steeb-k/fightstick-customized/Arcade-stick_bottom_board_v1_layout.png

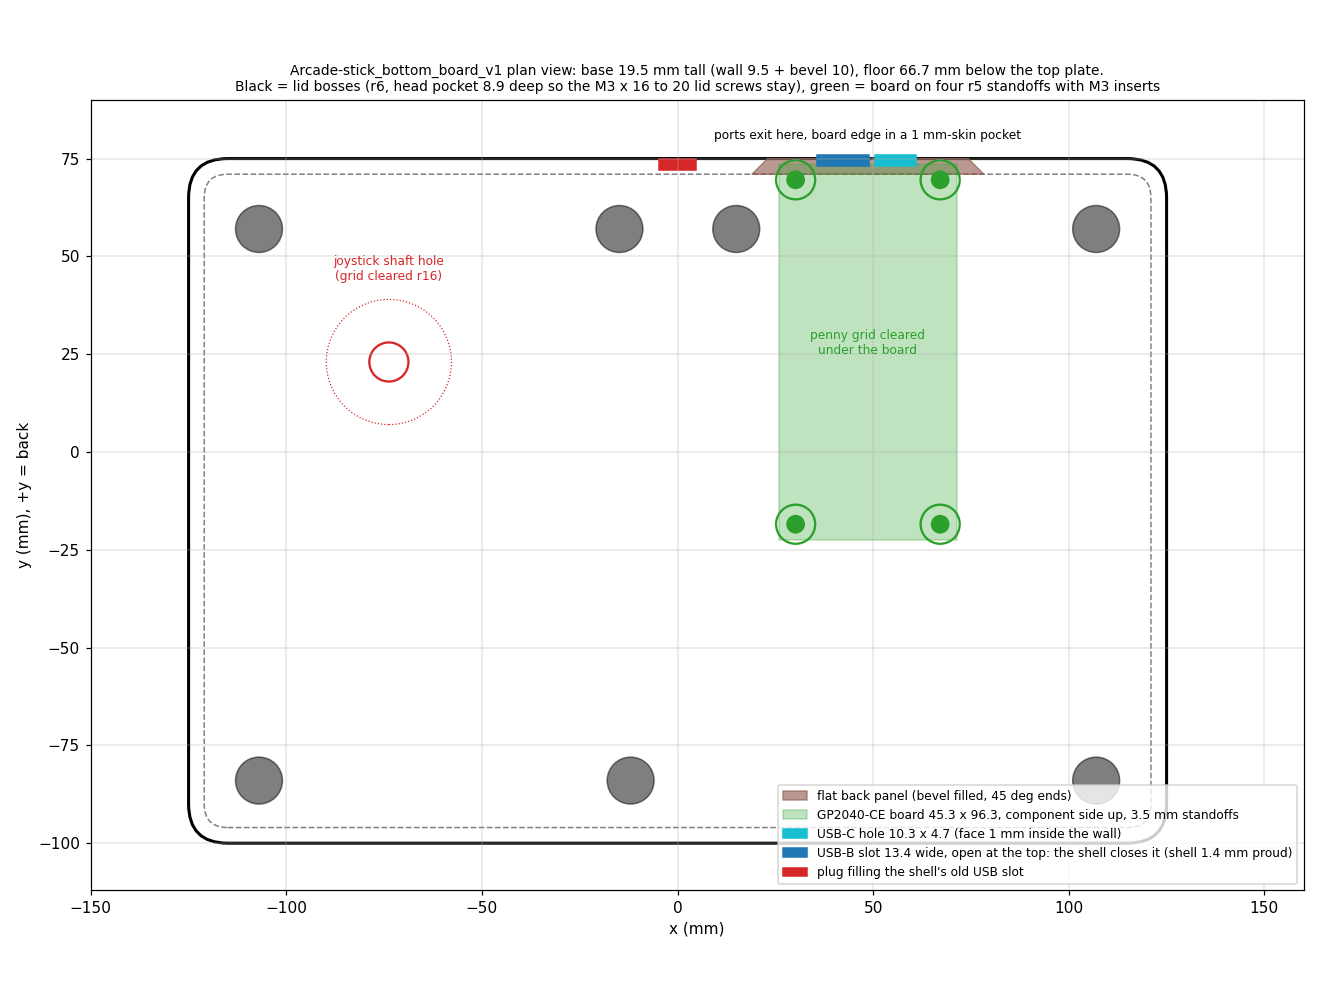
Arcade-stick_bottom_board_v1_layout.png
