steeb-k/fightstick-customized/Arcade-stick_top_v7_layout_layers.png

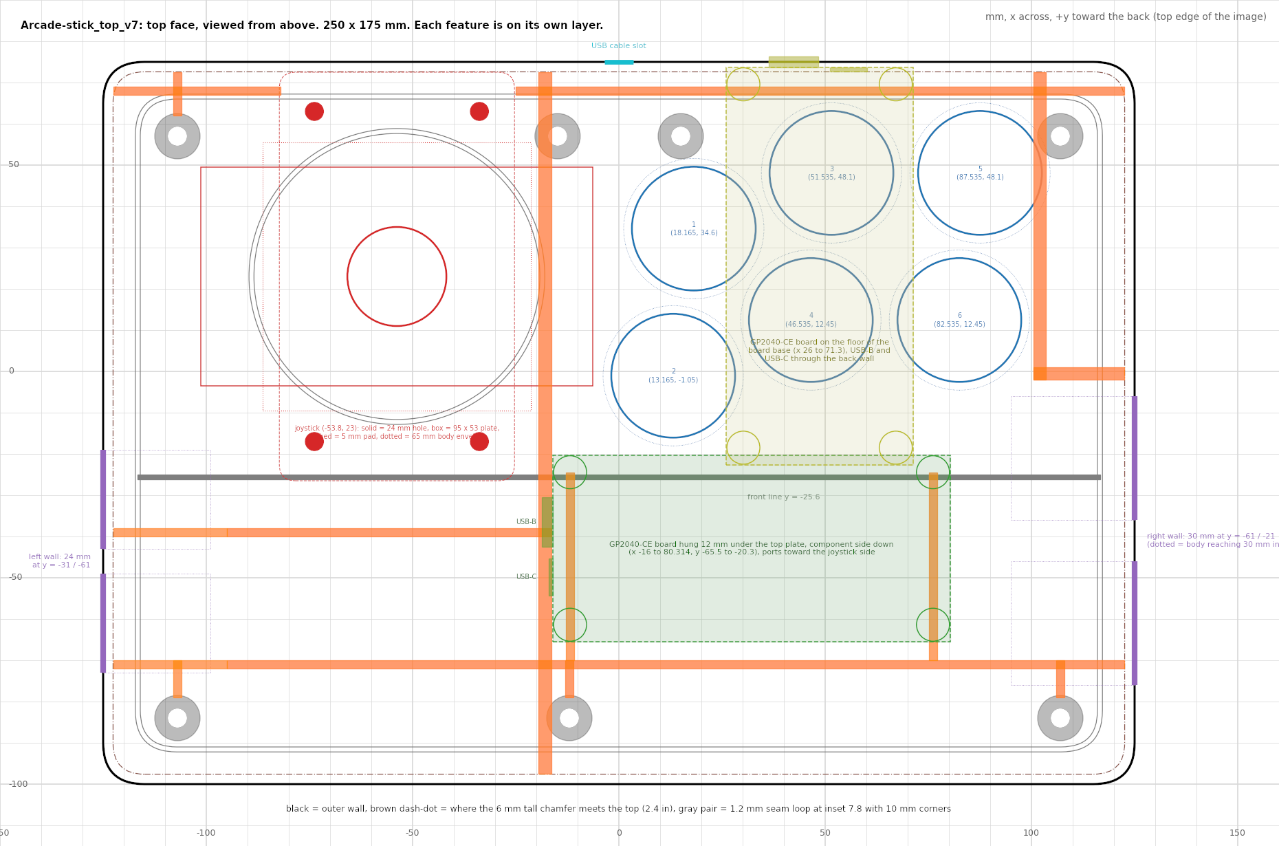
Arcade-stick_top_v7_layout_layers.png
