steeb-k/fightstick-customized/render_bottom_board_v1.png

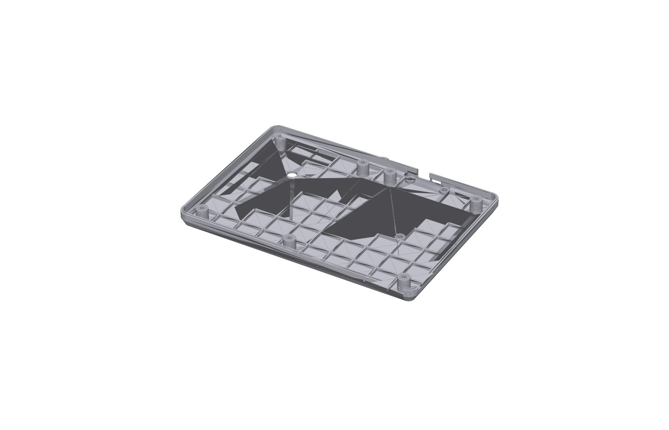
render_bottom_board_v1.png
