steeb-k/fightstick-customized/render_bottom_board_v1_back.png

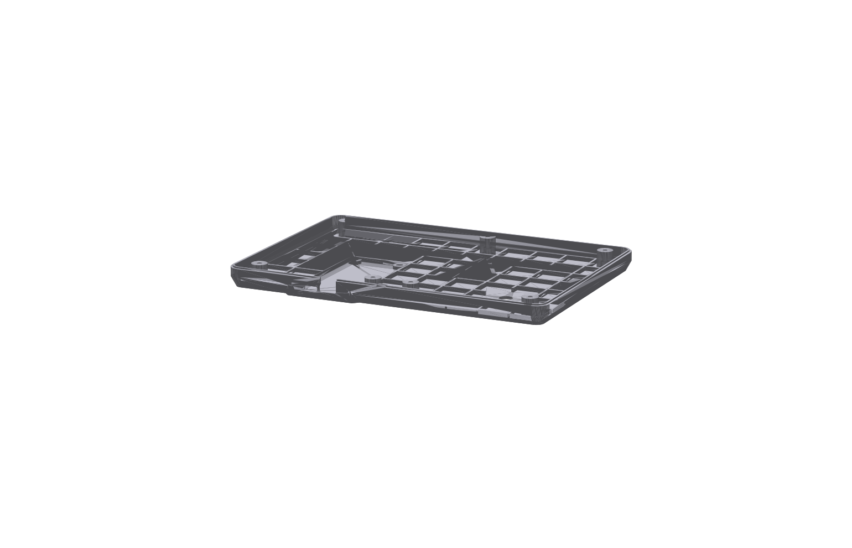
render_bottom_board_v1_back.png
