steeb-k/fightstick-customized/render_top_v7.png

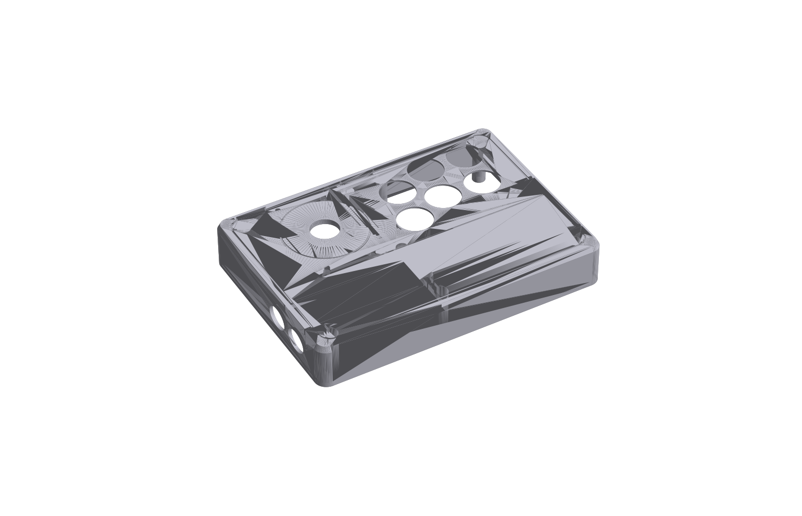
render_top_v7.png
