steeb-k/fightstick-customized/samples/plan_8btn.png

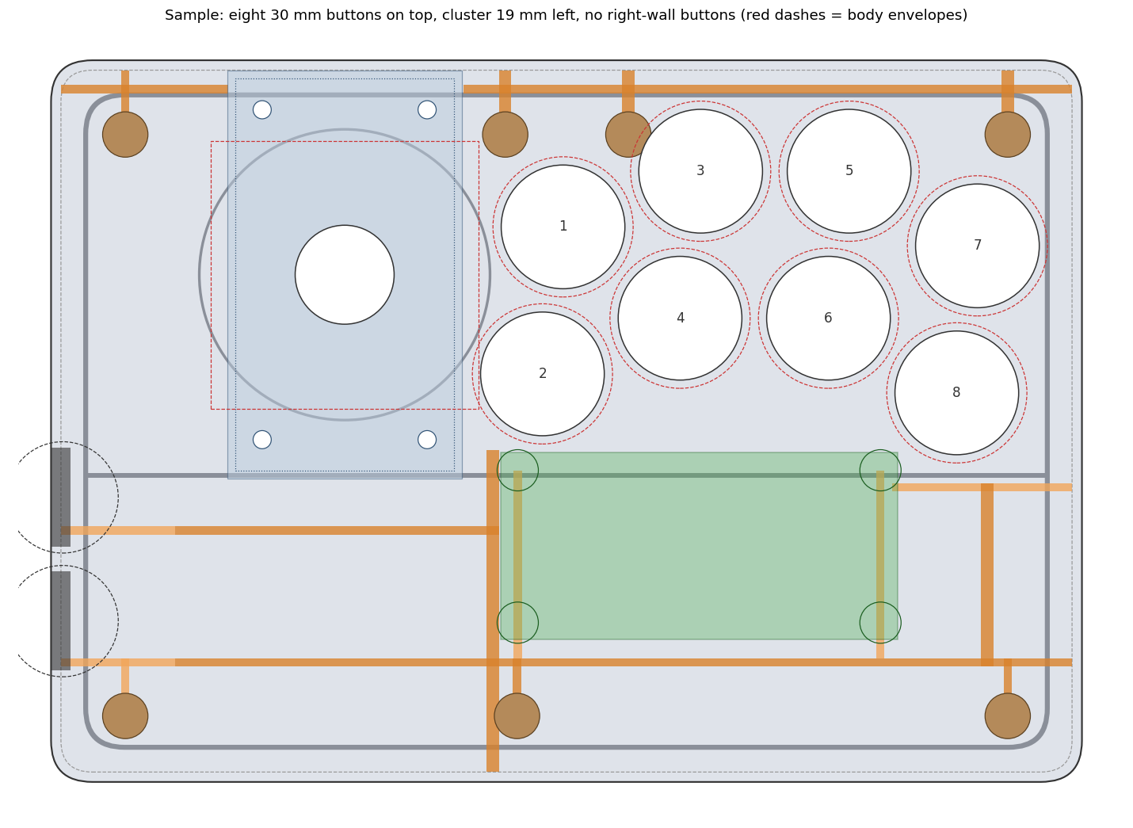
samples/plan_8btn.png
