steeb-k/fightstick-customized/samples/plan_diamond.png

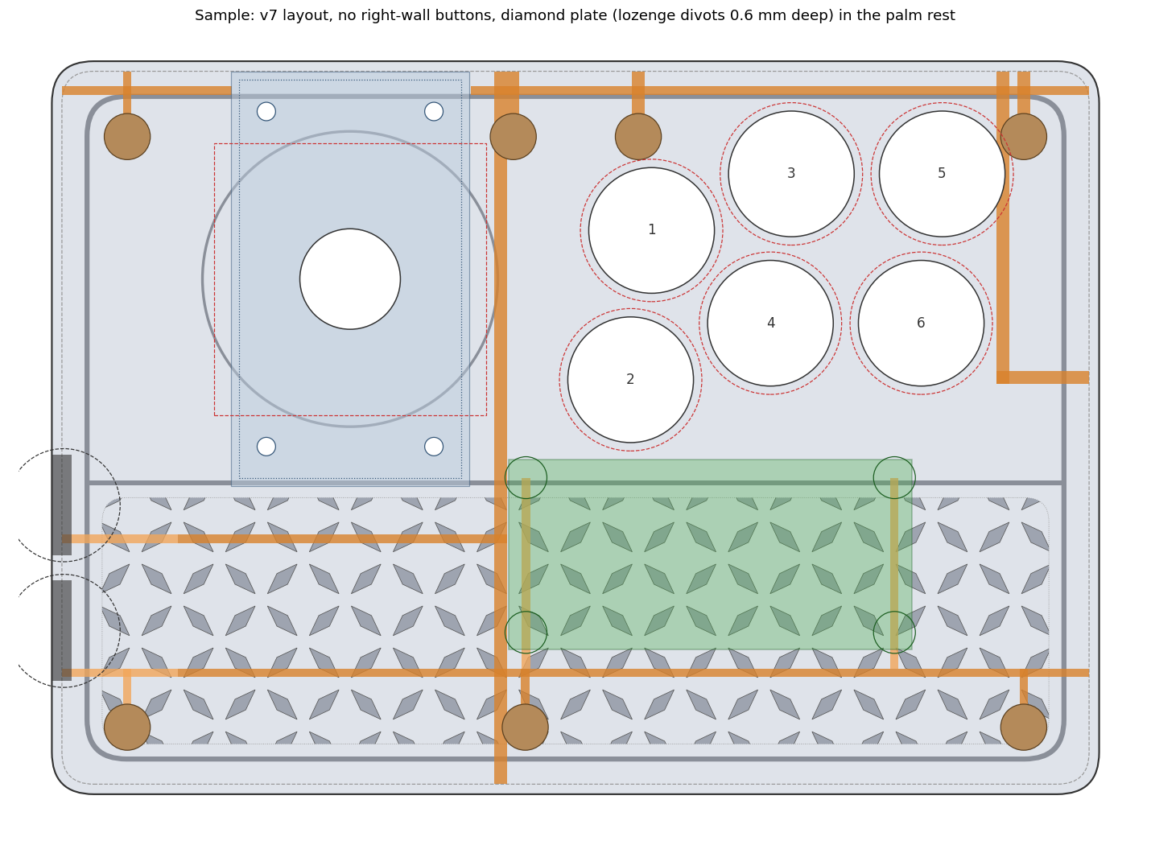
samples/plan_diamond.png
