steeb-k/fightstick-customized/samples/section_diamond_x0.png

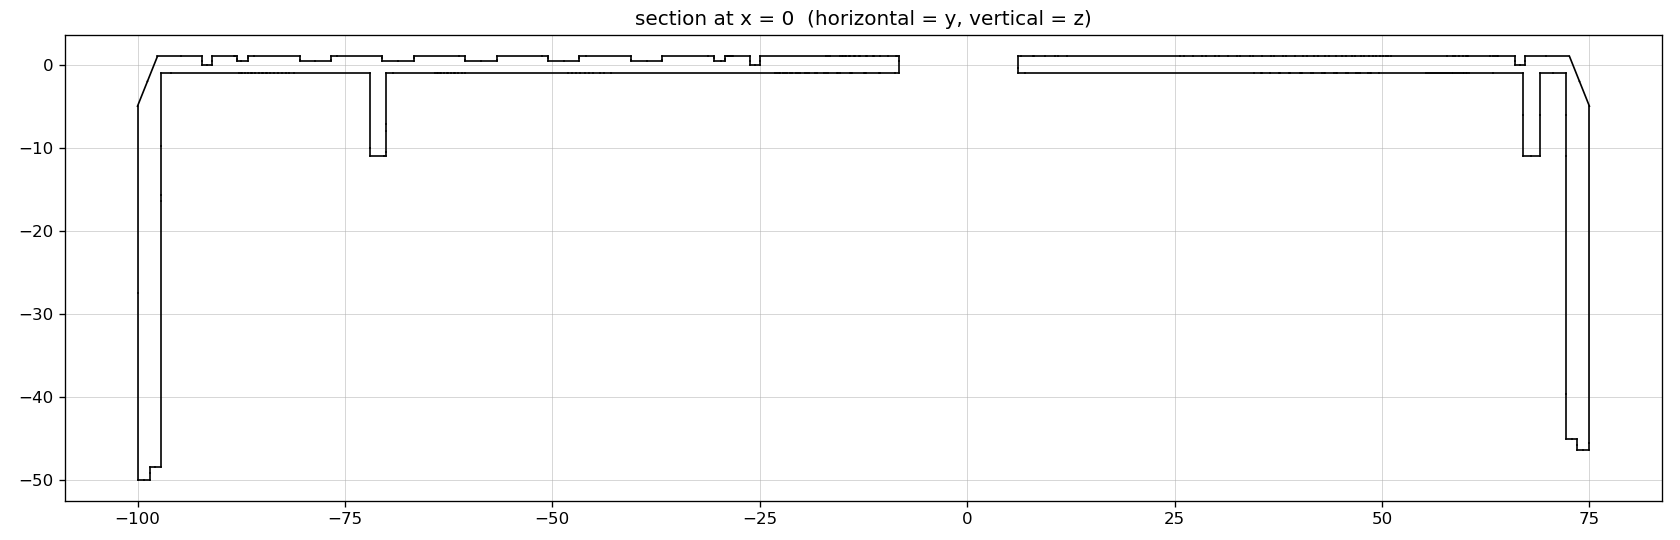
samples/section_diamond_x0.png
