steeb-k/fightstick-customized/section_board_v1_back.png

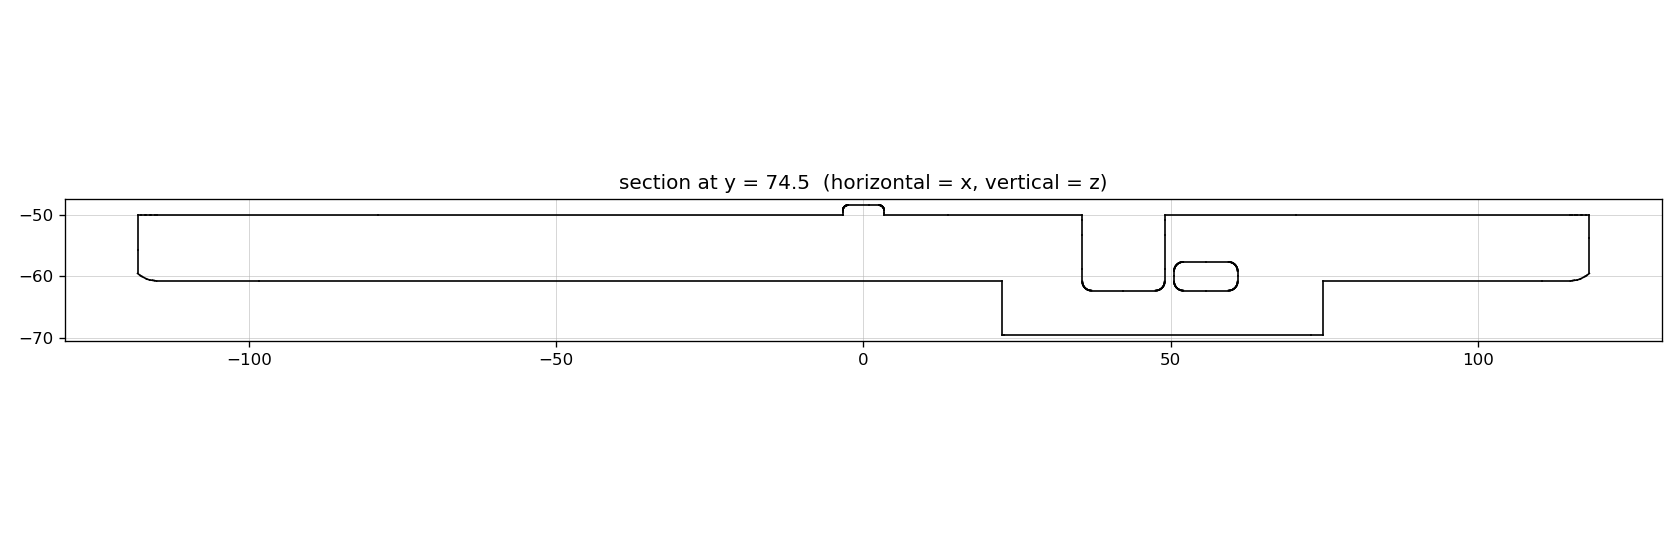
section_board_v1_back.png
