steeb-k/fightstick-customized/section_board_v1_ports.png

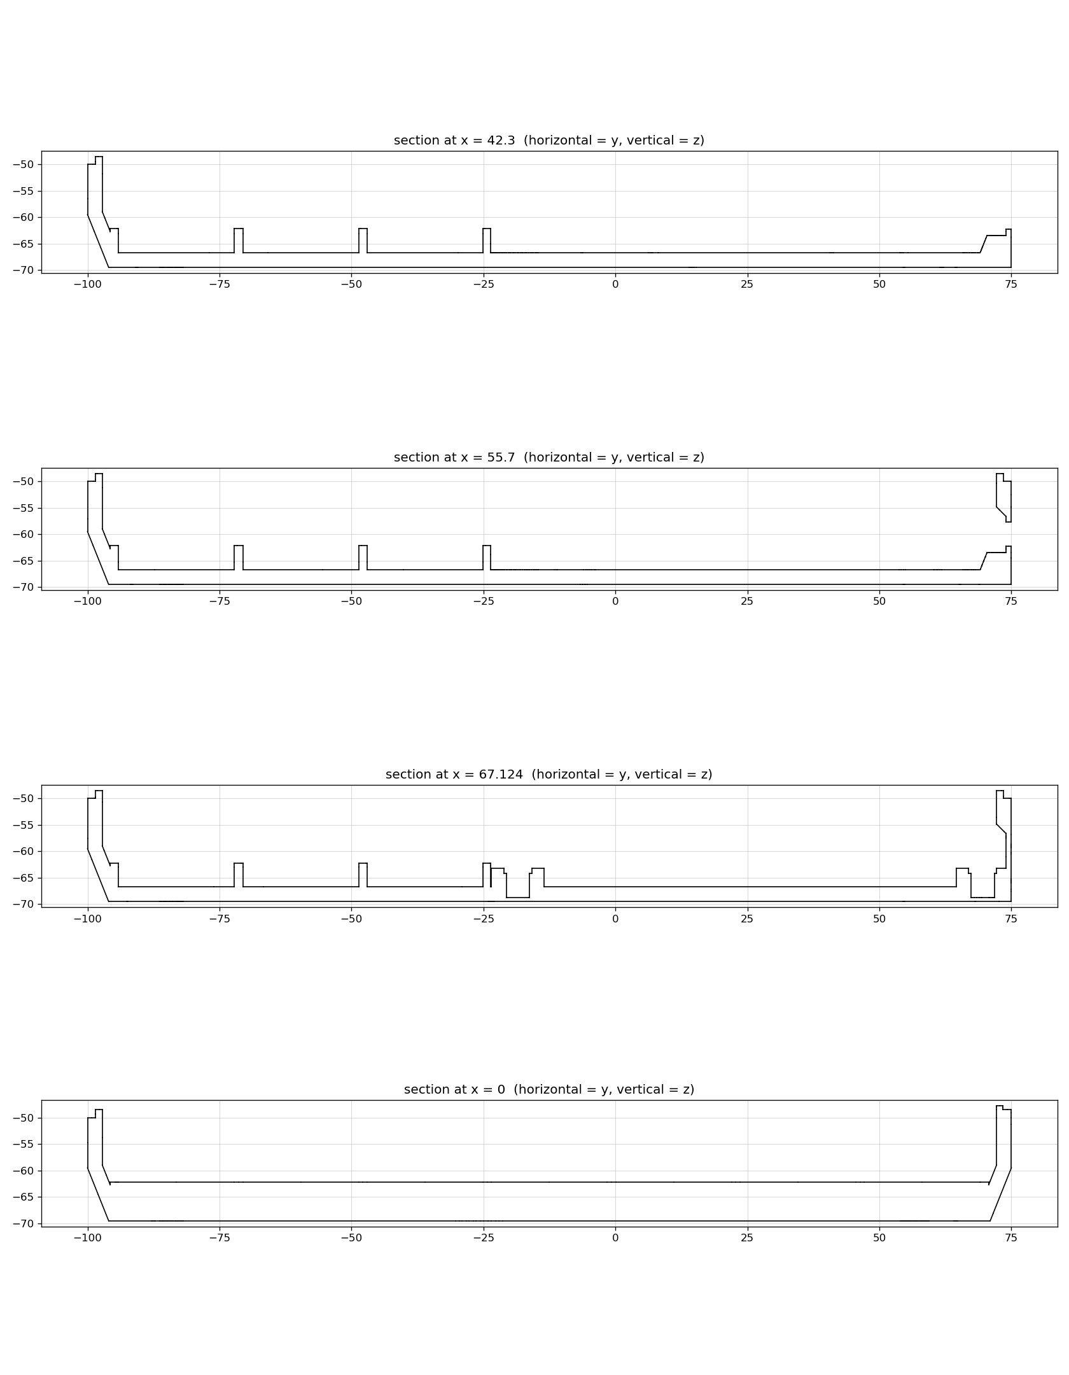
section_board_v1_ports.png
