steeb-k/fightstick-customized/section_v7_boss.png

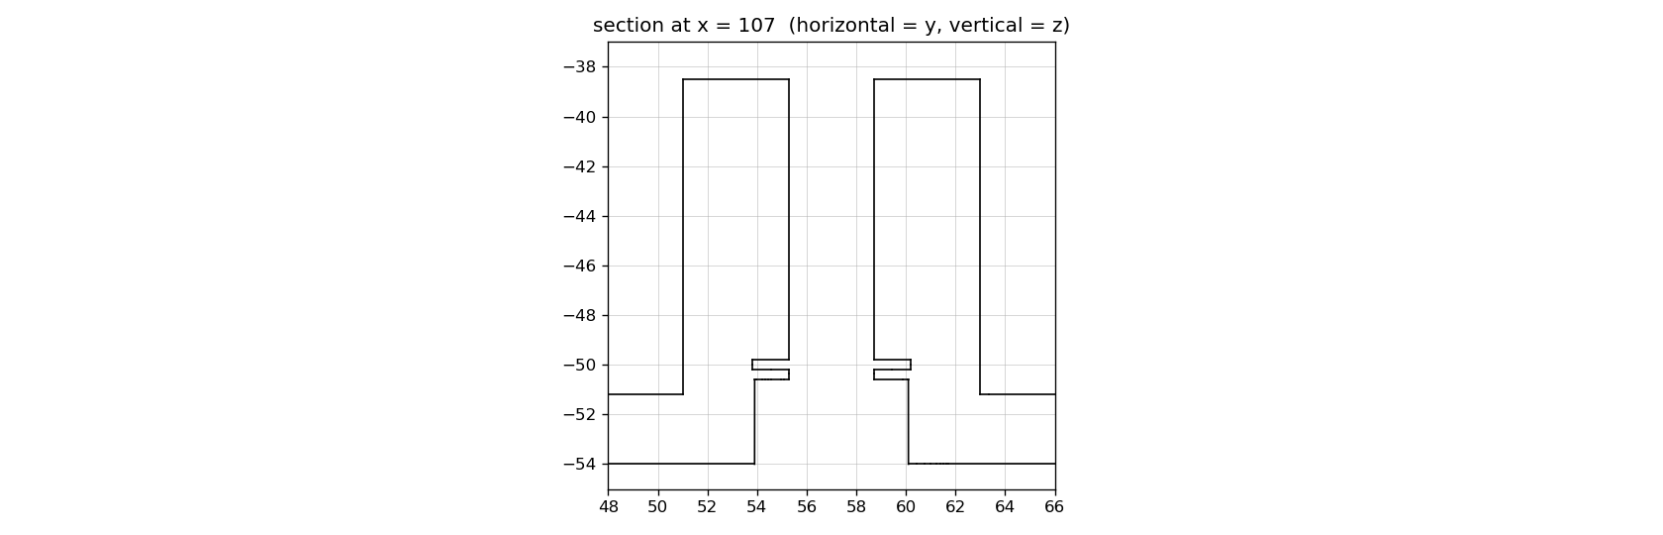
section_v7_boss.png
