steeb-k/fightstick-customized/section_v7_chamfer.png

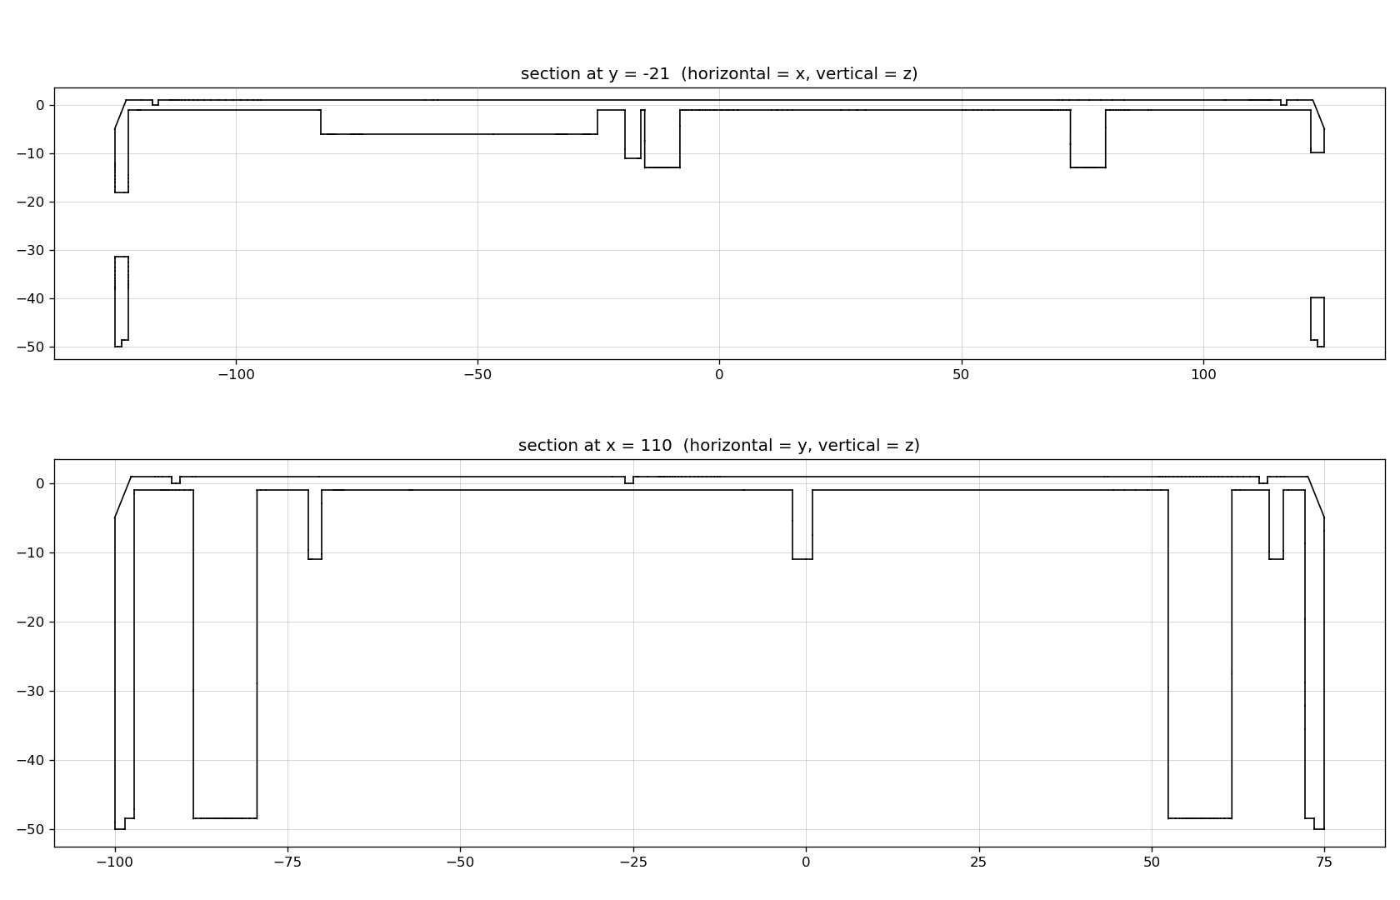
section_v7_chamfer.png
