steeb-k/fightstick-customized/section_v7_shell.png

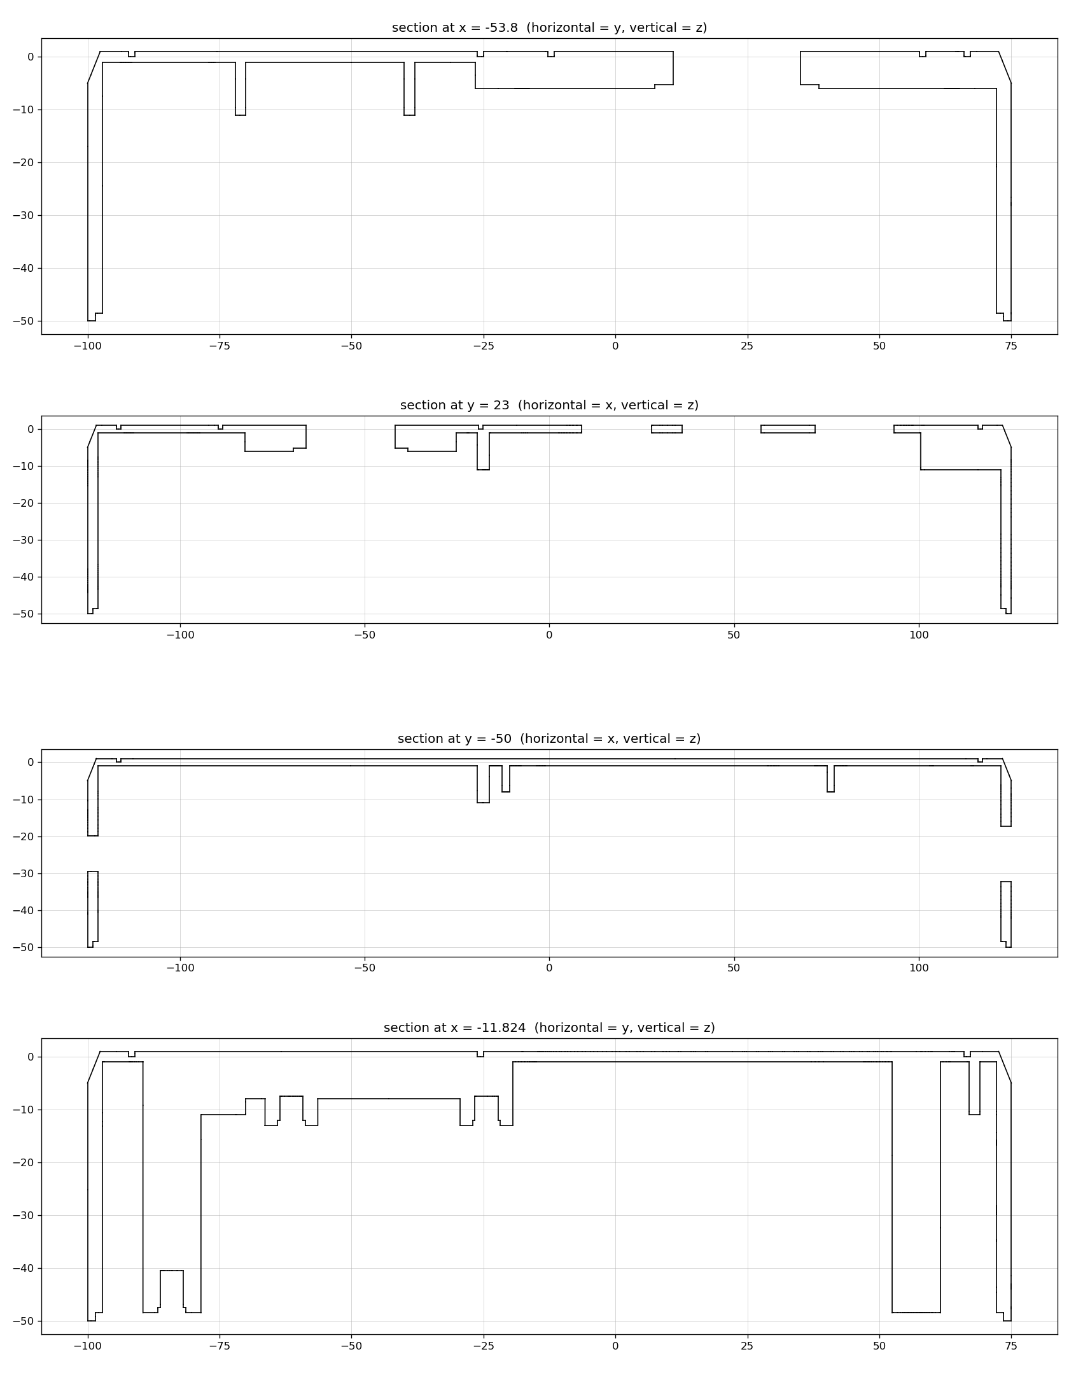
section_v7_shell.png
