steeb-k/fightstick-customized/Arcade-stick_top_v7.FCStd

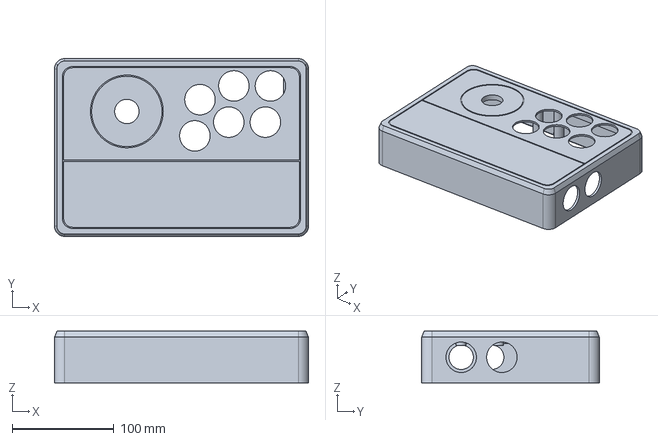
[picture p17: CAD file, 2026-11-08]
Arcade-stick_top_v7.FCStd
250.0 x 175.0 x 51.0 mm
