steeb-k/fightstick-customized/Arcade-stick_bottom_board_v1.FCStd

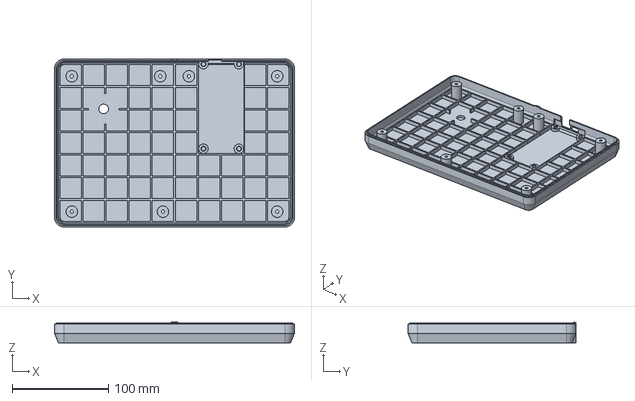
[picture p18: CAD file, 2026-11-08]
Arcade-stick_bottom_board_v1.FCStd
250.0 x 175.0 x 21.8 mm
