steeb-k/fightstick-customized/GP2040_post_test_jig.stl

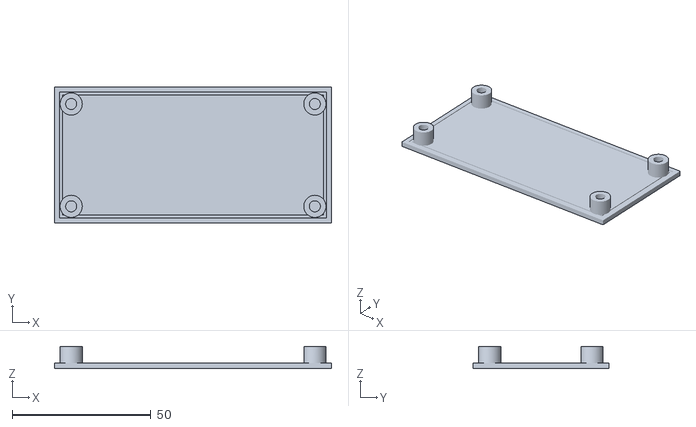
[picture p19: CAD file, 2026-11-08]
GP2040_post_test_jig.stl
100.0 x 49.0 x 8.00
