steeb-k/fightstick-customized/Arcade-stick_bottom_v7.FCStd

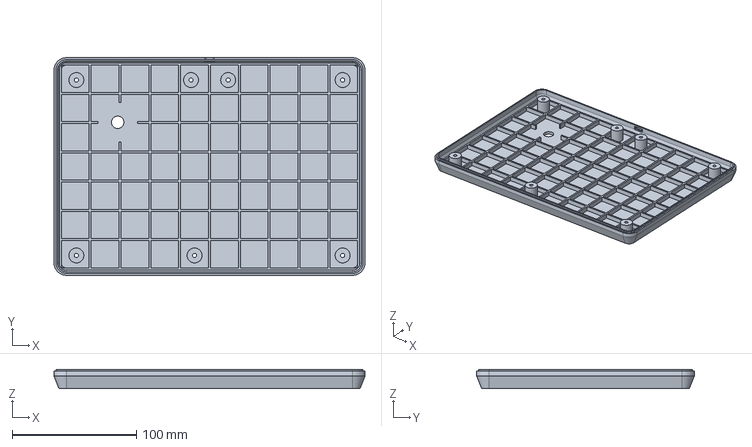
[picture p20: CAD file, 2026-11-08]
Arcade-stick_bottom_v7.FCStd
250.0 x 175.0 x 15.5 mm
