steeb-k/fightstick-customized/(list of files, cad)

Other CAD files:
samples/Arcade-stick_top_v7_sample_diamond.FCStd
samples/Arcade-stick_top_v7_sample_8btn.FCStd
Arcade-stick_bottom_board_v1.stl
Arcade-stick_bottom_v7.stl
Arcade-stick_top_v7.stl
samples/Arcade-stick_top_v7_sample_8btn.stl
samples/Arcade-stick_top_v7_sample_diamond.stl
