steeb-k/fightstick-customized/(commit log)

2026-11-08 Parametric 3D-printable fight stick enclosure: FreeCAD build script, v7 top shell, plain tray and board-on-the-floor base, sample variants, and docs
    [Arcade-stick_bottom_board_v1.FCStd, Arcade-stick_bottom_board_v1.stl, Arcade-stick_bottom_v7.FCStd, Arcade-stick_bottom_v7.stl, Arcade-stick_top_v7.FCStd, Arcade-stick_top_v7.stl, Arcade-stick_top_v7_sample_8btn.FCStd, Arcade-stick_top_v7_sample_8btn.stl]
2026-11-08 README: assembly animation at the top, exploded views of both bottom cases, MP4 fallback
